Elektrokrouzek-cz/electronic-dice-smd/3d/dice-SMD-btm.obj

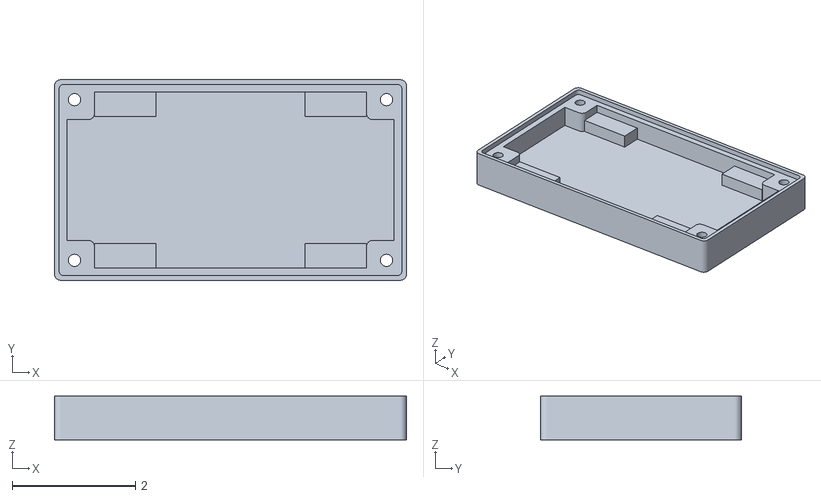
[picture p4: CAD file, 2025-11-01]
3d/dice-SMD-btm.obj
5.72 x 3.26 x 0.71
