Elektrokrouzek-cz/electronic-dice-smd/3d/dice-SMD-bottom.stl

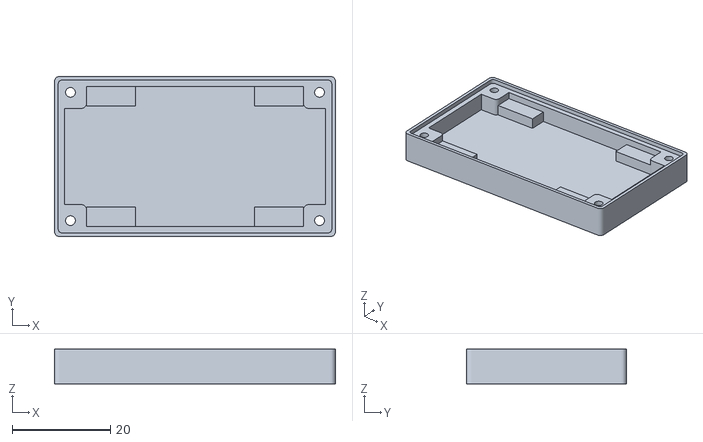
[picture p5: CAD file, 2025-11-01]
3d/dice-SMD-bottom.stl
57.2 x 32.6 x 7.10
