Elektrokrouzek-cz/electronic-dice-smd/3d/dice-SMD-top-with-hole.stl

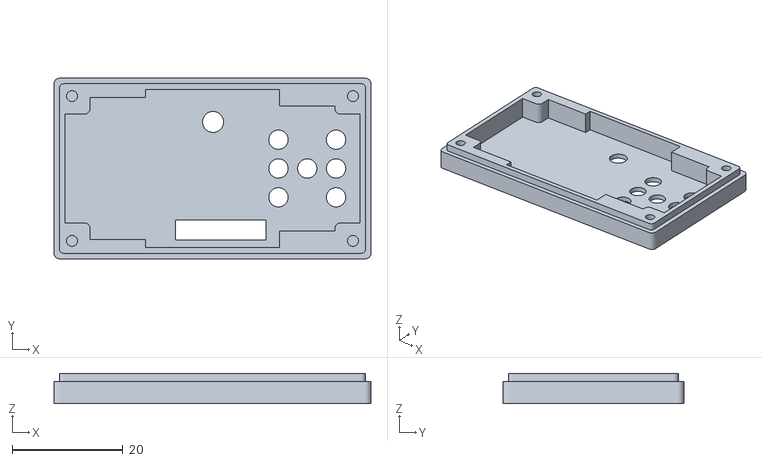
[picture p6: CAD file, 2025-11-01]
3d/dice-SMD-top-with-hole.stl
57.2 x 32.6 x 5.50
