Elektrokrouzek-cz/electronic-dice-smd/(list of files, cad)

Other CAD files:
3d/dice-SMD-top-no-hole.obj
3d/dice-SMD-top-with-hole.obj
3d/dice-SMD.f3d
