Elektrokrouzek-cz/electronic-dice-smd/kicad/kostka-smd.kicad_pcb

## KiCad design kicad/kostka-smd.kicad_pcb (2025-11-01)

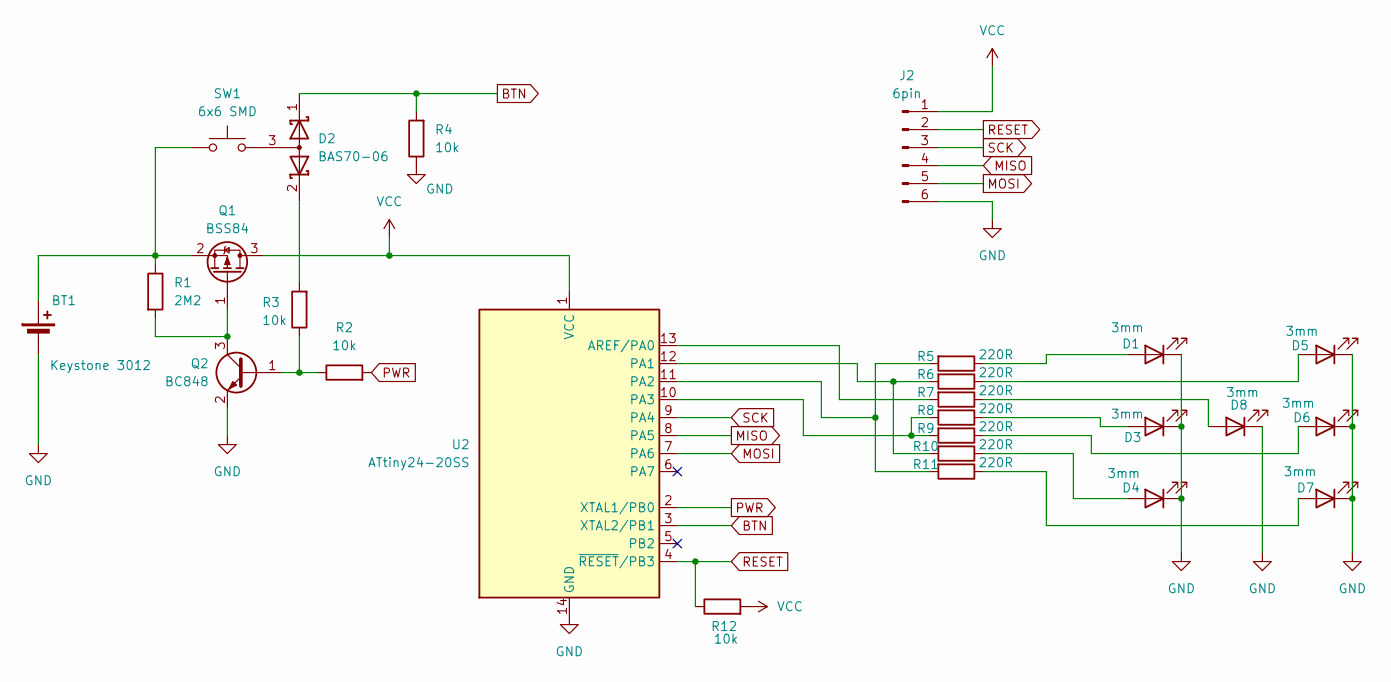
[picture p7: schematic kostka-smd.kicad_sch, Electronic dice (SMD)]

Parts:
BT1: Keystone 3012
D1, D3, D4, D5, D6, D7, D8: 3mm; LED_D3.0mm
D2: BAS70-06; SOT-23_Handsoldering
J2: 6pin; PinHeader_1x06_P2.54mm_Vertical
Q1: BSS84; SOT-23_Handsoldering
Q2: BC848; SOT-23_Handsoldering
R1: 2M2; R_1206_3216Metric_Pad1.30x1.75mm_HandSolder
R2, R3, R4, R12: 10k; R_1206_3216Metric_Pad1.30x1.75mm_HandSolder
R5, R6, R7, R8, R9, R10, R11: 220R; R_1206_3216Metric_Pad1.30x1.75mm_HandSolder
SW1: 6x6 SMD; SW_SPST_PTS645
U2: ATtiny24-20SS; SOIC-14_3.9x8.7mm_P1.27mm

Connections:
BTN: D2.1 (K), R4.2, U2.3 (XTAL2/PB1)
GND: BT1.2 (-), D1.1 (K), D3.1 (K), D4.1 (K), D5.1 (K), D6.1 (K), D7.1 (K), D8.1 (K), J2.6, Q2.2 (E), R4.1, U2.14 (GND)
MISO: J2.4, U2.8 (PA5)
MOSI: J2.5, U2.7 (PA6)
unnamed: BT1.1 (+), Q1.2 (S), R1.1, SW1.1
unnamed: D1.2 (A), R5.1
unnamed: D2.3 (A), SW1.2
unnamed: D2.2 (K), R3.2
unnamed: D3.2 (A), R8.1
unnamed: D4.2 (A), R10.1
unnamed: D5.2 (A), R6.1
unnamed: D6.2 (A), R9.1
unnamed: D7.2 (A), R11.1
unnamed: D8.2 (A), R7.1
unnamed: Q1.1 (G), Q2.3 (C), R1.2
unnamed: Q2.1 (B), R2.1, R3.1
unnamed: R7.2, U2.13 (AREF/PA0)
unnamed: R6.2, R10.2, U2.12 (PA1)
unnamed: R5.2, R11.2, U2.11 (PA2)
unnamed: R8.2, R9.2, U2.10 (PA3)
PWR: R2.2, U2.2 (XTAL1/PB0)
RESET: J2.2, R12.1, U2.4 (~RESET/PB3)
SCK: J2.3, U2.9 (PA4)
VCC: J2.1, Q1.3 (D), R12.2, U2.1 (VCC)

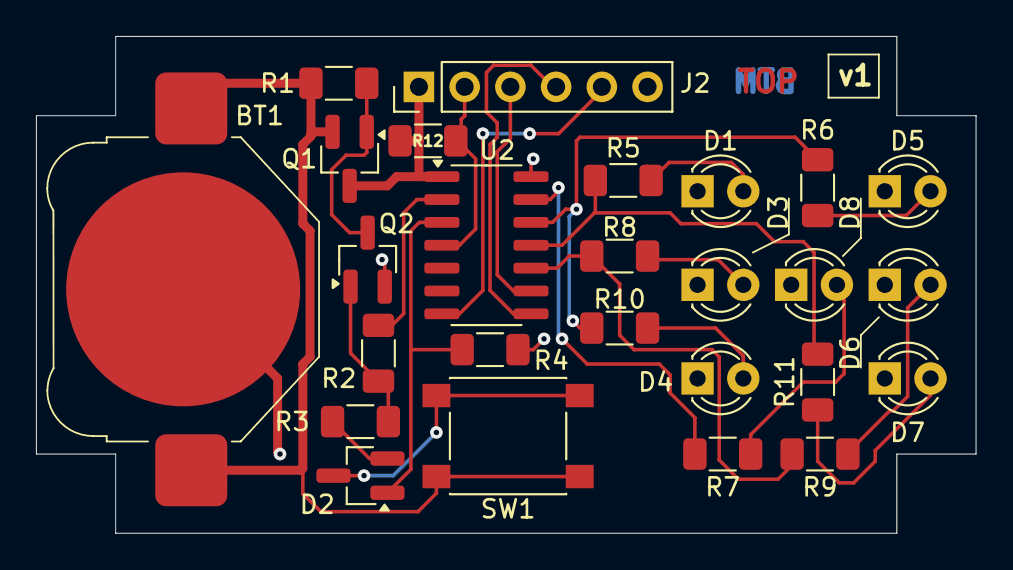
[picture p8: board kostka-smd.kicad_pcb from above]

Board: 2 copper layers, 52.2 x 27.6 mm, 26 parts (0 on the bottom side), 24 nets.
