Elektrokrouzek-cz/electronic-dice-smd/(commit log)

2025-11-01 Source code and binary added, documentation update
    [kostka-smd.kicad_pcb]
2025-11-01 BOM added
    [bom.xlsx]
